Kiubek8/Infrared-light-position-based-headtracker/Images/trackIrBackSide.jpg

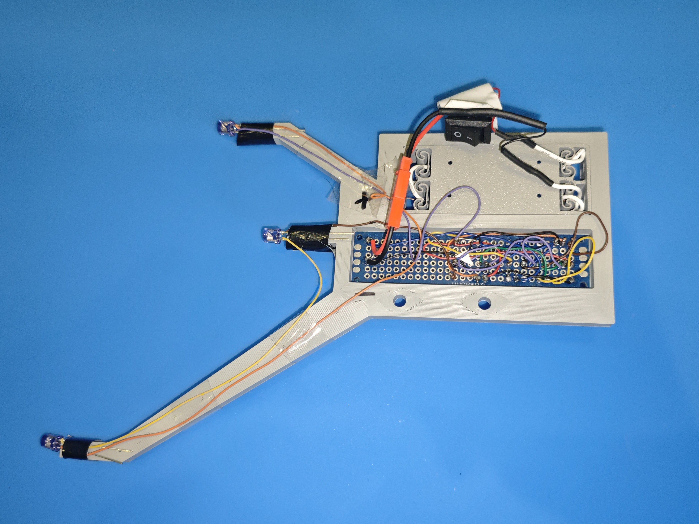
Images/trackIrBackSide.jpg
