Kiubek8/Infrared-light-position-based-headtracker/CADFiles/trackIR_battery_plate_FINAL[M4.5nonThreaded_NewHoleProfile].FCStd

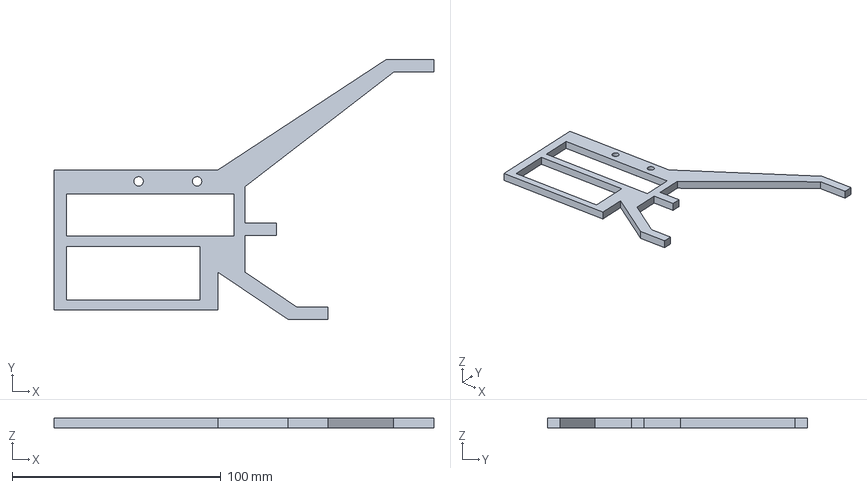
[picture p8: CAD file, 2026-07-14]
CADFiles/trackIR_battery_plate_FINAL[M4.5nonThreaded_NewHoleProfile].FCStd
181.9 x 124.3 x 5.00 mm
