Kiubek8/Infrared-light-position-based-headtracker/CADFiles/trackIR_battery_plate_V8[M4.5NewHoleProfile].FCStd

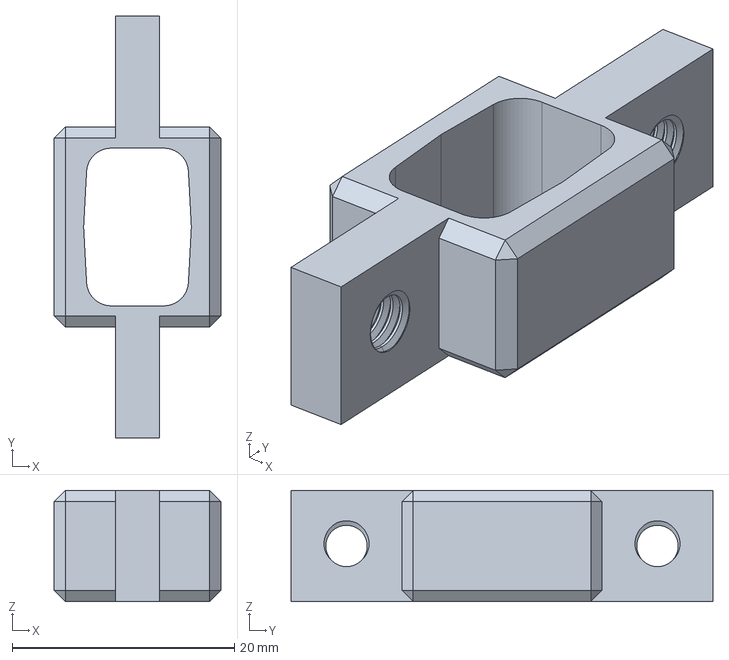
[picture p9: CAD file, 2026-07-14]
CADFiles/trackIR_battery_plate_V8[M4.5NewHoleProfile].FCStd
15.0 x 38.0 x 10.0 mm
