Kiubek8/Infrared-light-position-based-headtracker/CADFiles/trackIR_battery_plate_V8[M4.5nonThreaded_NewHoleProfile].FCStd

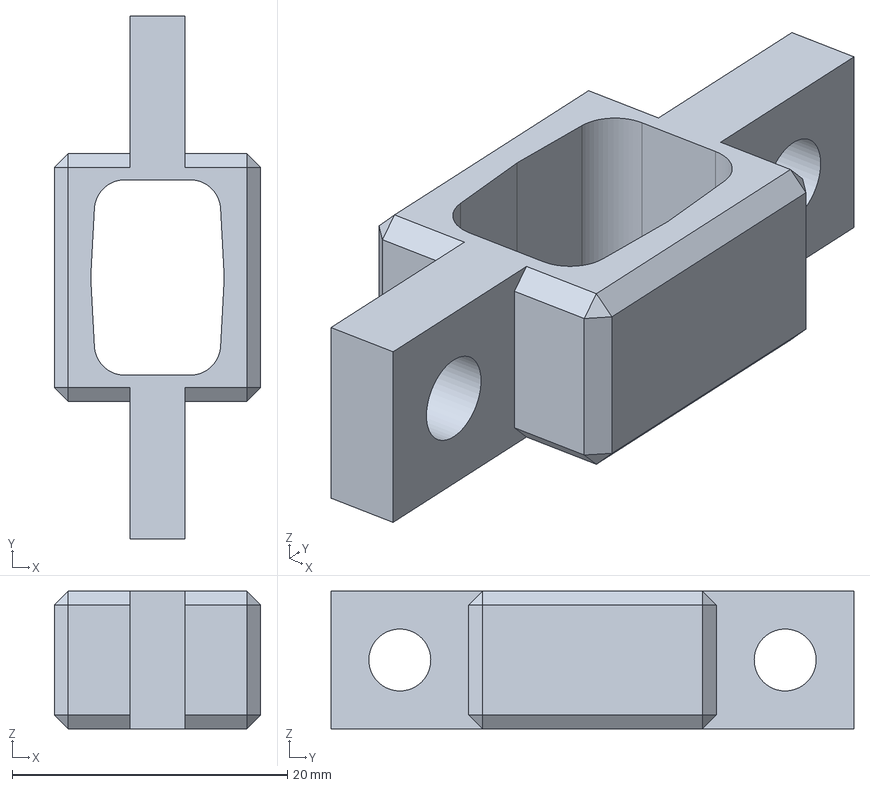
[picture p10: CAD file, 2026-07-14]
CADFiles/trackIR_battery_plate_V8[M4.5nonThreaded_NewHoleProfile].FCStd
15.0 x 38.0 x 10.0 mm
