Kiubek8/Infrared-light-position-based-headtracker/CADFiles/trackIR_battery_plateV6.FCStd

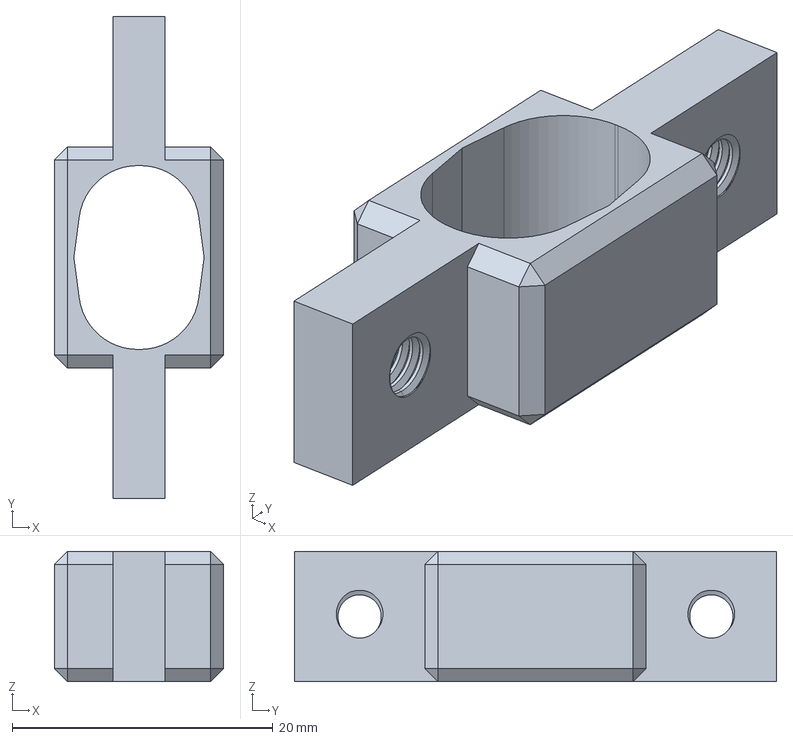
[picture p11: CAD file, 2026-07-14]
CADFiles/trackIR_battery_plateV6.FCStd
13.0 x 37.0 x 10.0 mm
