Kiubek8/Infrared-light-position-based-headtracker/3DFiles/trackir_v4.3mf

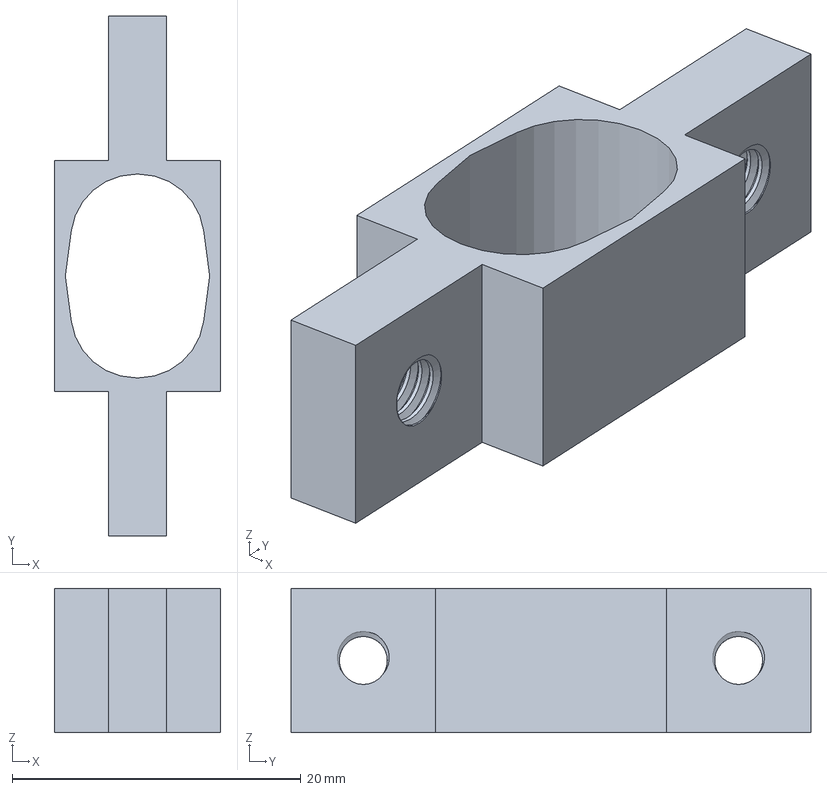
[picture p12: CAD file, 2026-07-14]
3DFiles/trackir_v4.3mf
11.5 x 36.0 x 10.0 mm
