Kiubek8/Infrared-light-position-based-headtracker/CADFiles/trackIR_batteryPlateV3.FCStd

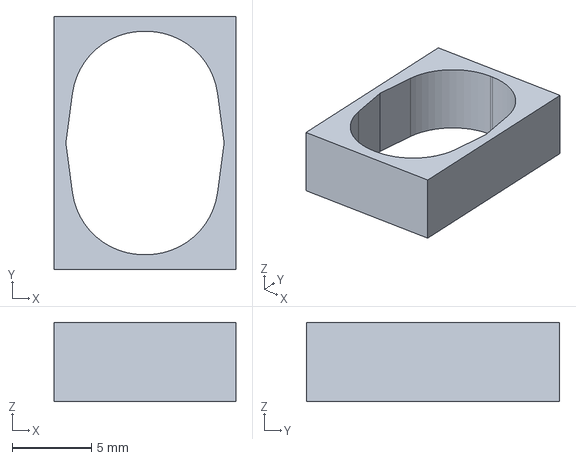
[picture p13: CAD file, 2026-07-14]
CADFiles/trackIR_batteryPlateV3.FCStd
11.5 x 16.0 x 5.00 mm
