Kiubek8/Infrared-light-position-based-headtracker/CADFiles/trackIR.FCStd

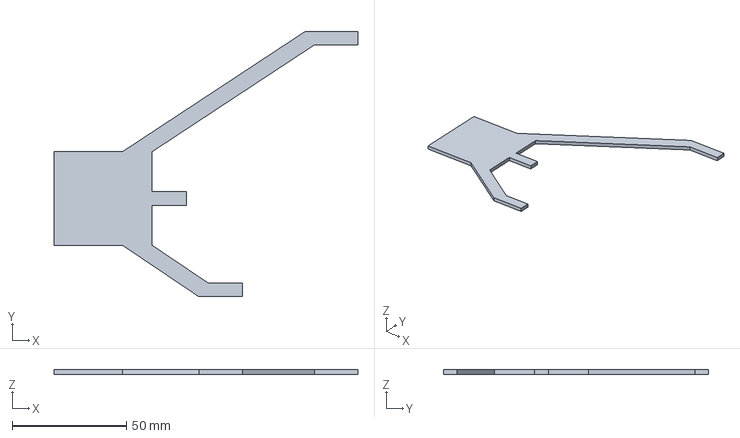
[picture p14: CAD file, 2026-07-14]
CADFiles/trackIR.FCStd
133.2 x 116.3 x 2.00 mm
