Kiubek8/Infrared-light-position-based-headtracker/3DFiles/trackir_v3.3mf

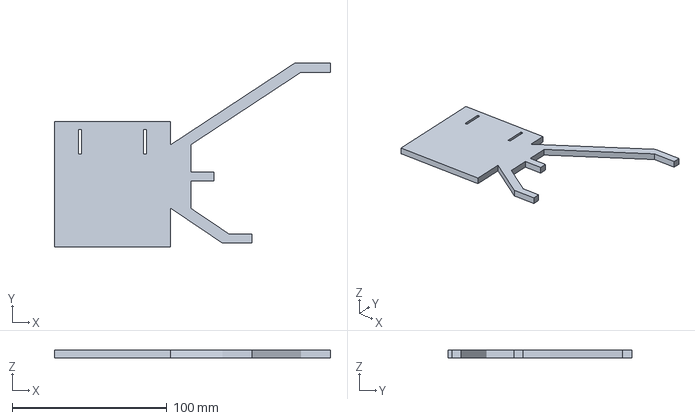
[picture p15: CAD file, 2026-07-14, an earlier design]
3DFiles/trackir_v3.3mf
178.2 x 118.8 x 5.00 mm
