Kiubek8/Infrared-light-position-based-headtracker/CADFiles/trackIR_battery_plate_V4.FCStd

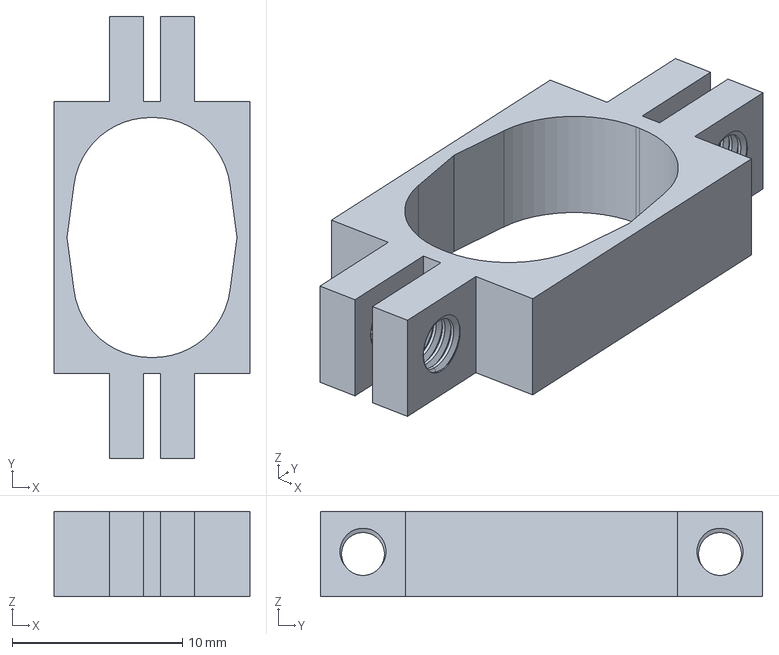
[picture p16: CAD file, 2026-07-14, an earlier design]
CADFiles/trackIR_battery_plate_V4.FCStd
11.5 x 26.0 x 5.00 mm
