Kiubek8/Infrared-light-position-based-headtracker/(list of files, cad)

Other CAD files:
3DFiles/trackir_v5FInal.3mf
CADFiles/trackIR_battery_plate.FCStd
CADFiles/trackIrV1.FCStd
CADFiles/trackIR_battery_plate_V7[sameScrewsNewHoleProfile].FCStd
CADFiles/trackIR_battery_plate_V6[tooSmallHolesOldProfile].FCStd
CADFiles/trackIR_battery plateV2.FCStd
3DFiles/trackir_v2.3mf
CADFiles/trackIR_battery plateV1.FCStd
CADFiles/trackIR_battery_plate_V5.FCStd
3DFiles/Trackir_v1.3mf
